marcel3032/konstrukckoprobojogeometria/readme.md

# Repo k robotickej hre na LTT 2022

Stavajú sa roboty z ESP32, ktoré robí webserver.
Roboty sú ovládané cez browser, po pripojení sa na stránku, ktorú ESP hostuje.

Existuje aj build dokumentácie, ktorý je na [https://marcel3032.github.io/konstrukckoprobojogeometria/](https://marcel3032.github.io/konstrukckoprobojogeometria/)

Tento repozitár si buď môžete [rovno stiahnuť](http://server.ltt:7000/ltt/KPG/archive/master.zip),
ale v prípade, že ste už niekedy robili v git-om/githubom,
je odporúčané si ho clonenúť:

`git clone http://server.ltt:7000/ltt/KPG.git`
