marcel3032/konstrukckoprobojogeometria/docs/source/images/zip-libraries.png

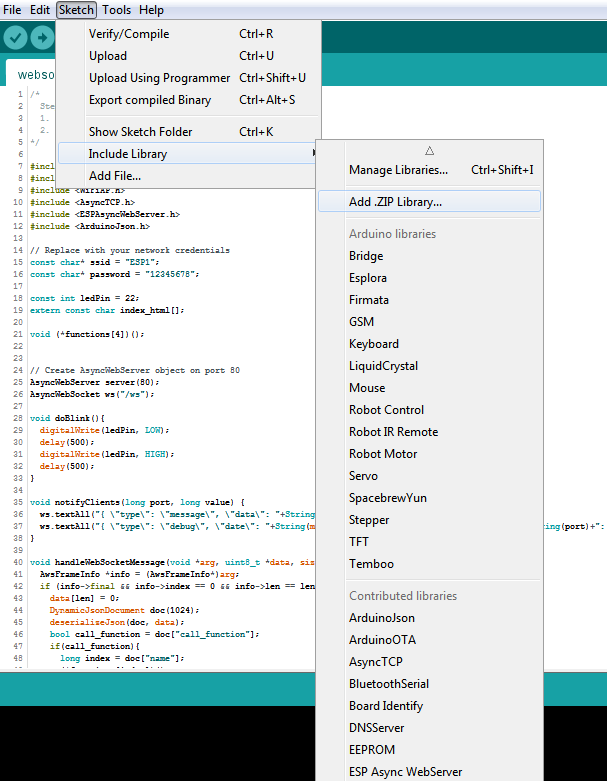
docs/source/images/zip-libraries.png
