marcel3032/konstrukckoprobojogeometria/(commit log)

2022-07-21 fix forgotten hardcoded port number on server, add sliders for motor testing
    [websocket-server.ino]
2022-07-31 add esp32 pinout
2022-08-03 update installation file info, add something like motor controlling
2022-08-04 small code cleanup, update motorWrite
2022-08-05 fix-for-ide-2.0: add analogwrite library (#12)
    [websocket-server.ino]
2022-08-06 html indenation fix, add performLoop file
    [websocket-server.ino]
2022-08-10 add arduino code docs, rename arduino project
2022-08-10 add led and buzzer schema
2022-08-12 update js mime type, fix debug table
    [websocket_server.ino]
2022-08-13 led and buzzer info update
